vivek5391/6dof-robotic-arm-ros2/cad/sg servo.step

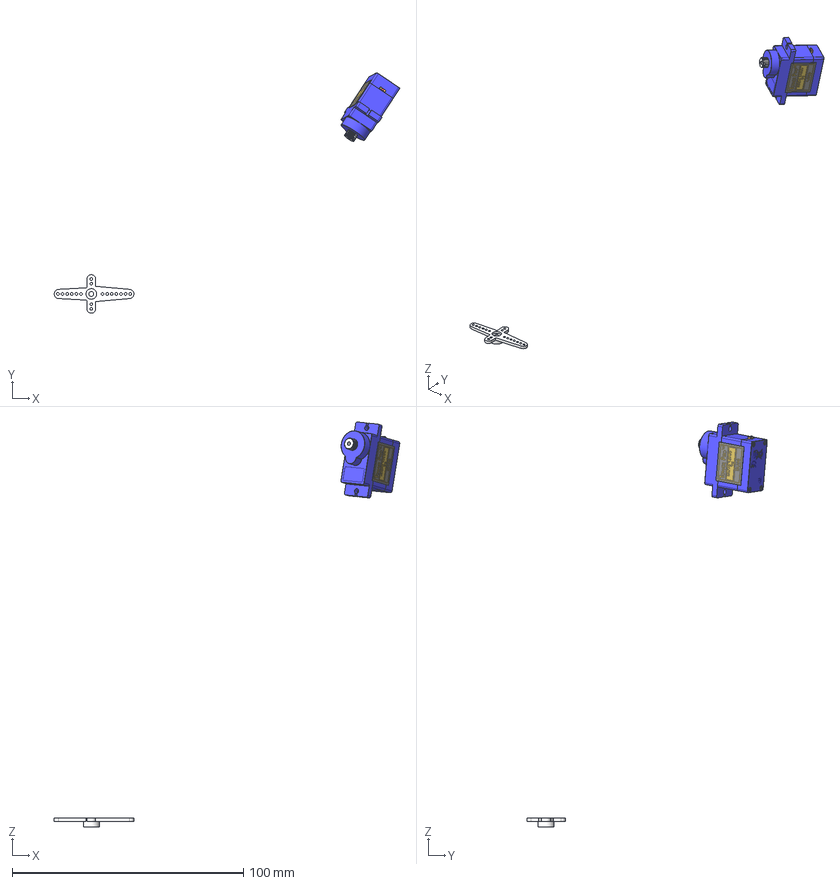
[picture p1: CAD file, 2026-10-06]
cad/sg servo.step
149.6 x 104.1 x 175.3 mm
SG90 - Micro Servo 9g - Tower Pro.1_Pea
SG90 - Micro Servo 9g - Tower Pro.4_Pea
