vivek5391/6dof-robotic-arm-ros2/meshes/gripper_right_finger.stl

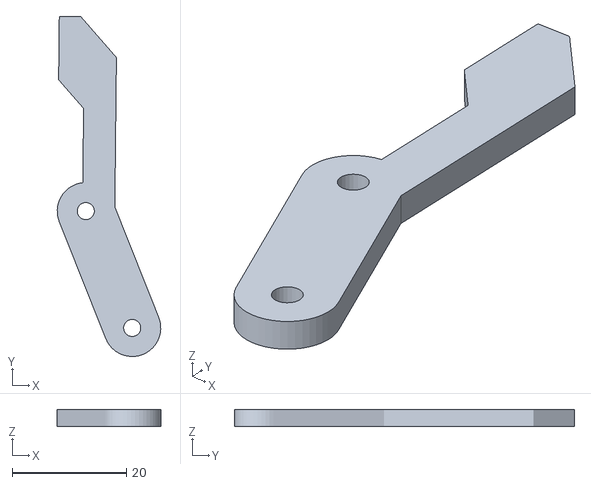
[picture p2: CAD file, 2026-10-06]
meshes/gripper_right_finger.stl
18.1 x 59.5 x 3.00
