vivek5391/6dof-robotic-arm-ros2/cad/body1.step

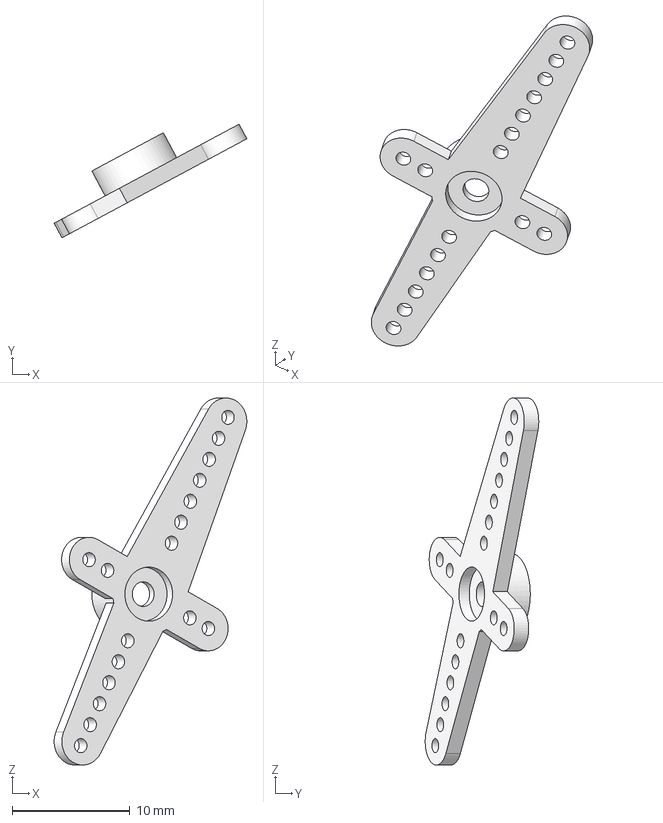
[picture p3: CAD file, 2026-10-06]
cad/body1.step
16.4 x 9.65 x 31.2 mm
