vivek5391/6dof-robotic-arm-ros2/meshes/gripper_left_gear.stl

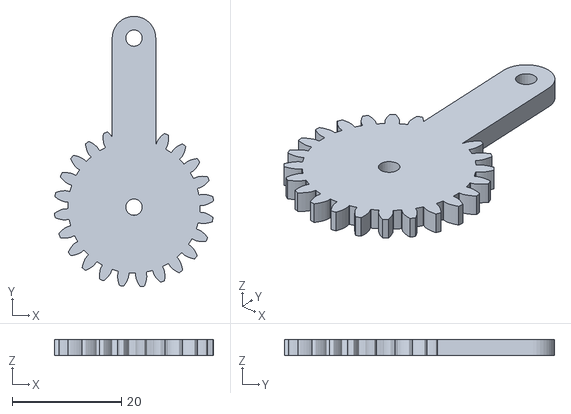
[picture p4: CAD file, 2026-10-06]
meshes/gripper_left_gear.stl
29.2 x 49.6 x 3.00
