vivek5391/6dof-robotic-arm-ros2/cad/DOF Robotic arm v2.step

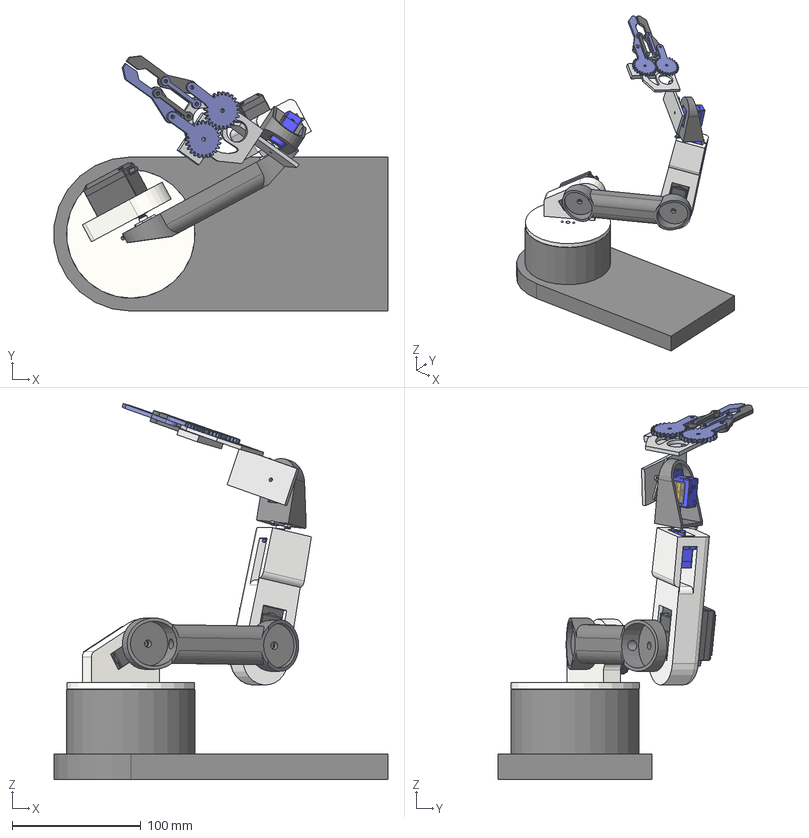
[picture p5: CAD file, 2026-10-06]
cad/DOF Robotic arm v2.step
259.6 x 198.6 x 292.6 mm
Shoulder
Elbow
arm
Base
Wrist
Spur Gear (24 teeth) (1)
Component2(Mirror)
Component1(Mirror)
SG90 - Micro Servo 9g - Tower Pro.1_Pea x 2
SG90 - Micro Servo 9g - Tower Pro.4_Pea x 2
SG90 - Micro Servo 9g - Tower Pro.4_Pea_1 x 3
