vivek5391/6dof-robotic-arm-ros2/meshes/Gripper v4.stl

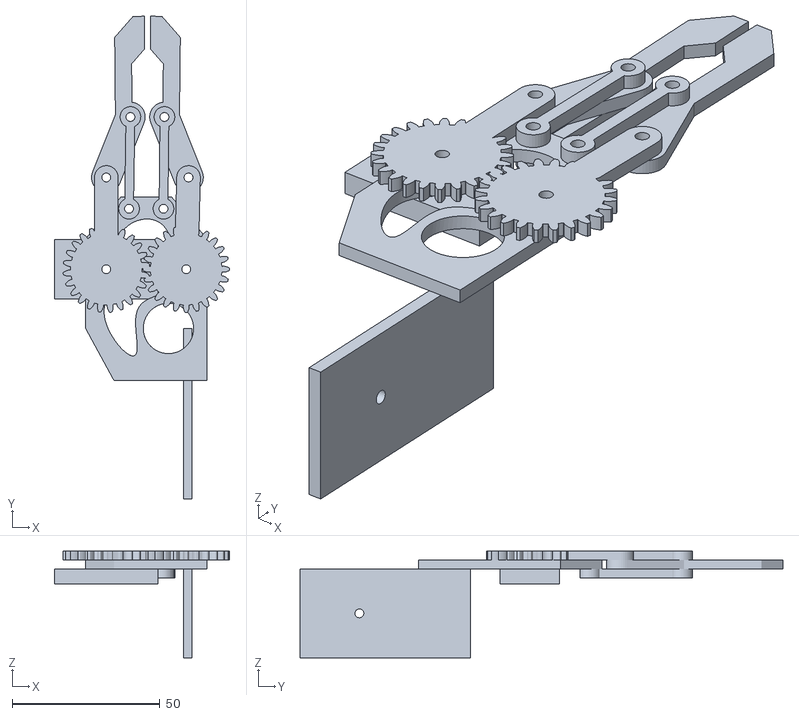
[picture p6: CAD file, 2026-10-06]
meshes/Gripper v4.stl
59.1 x 163.0 x 36.0
