vivek5391/6dof-robotic-arm-ros2/cad/MG995 v2 (1).step

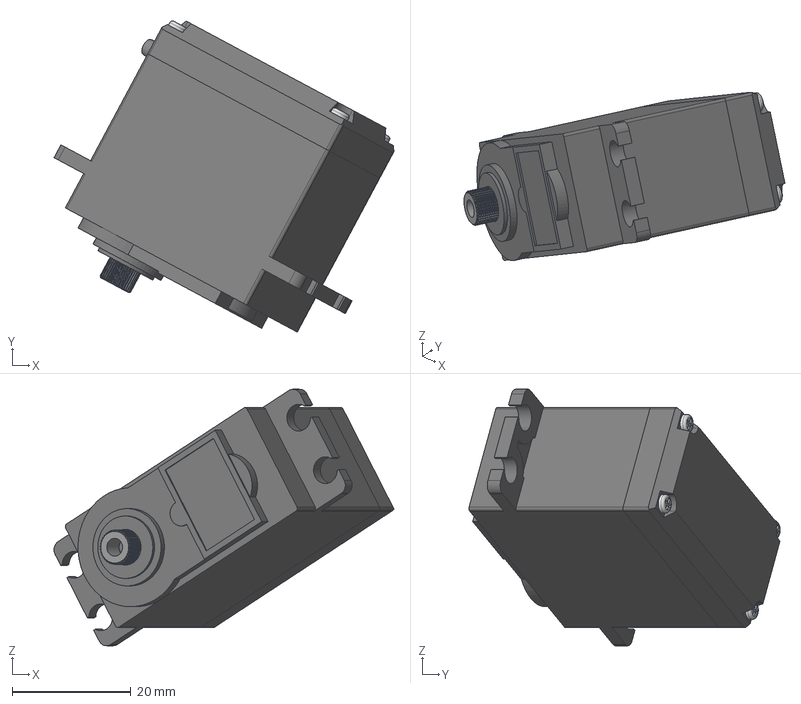
[picture p7: CAD file, 2026-10-06]
cad/MG995 v2 (1).step
57.2 x 52.4 x 43.1 mm
