vivek5391/6dof-robotic-arm-ros2/meshes/Shoulder.stl

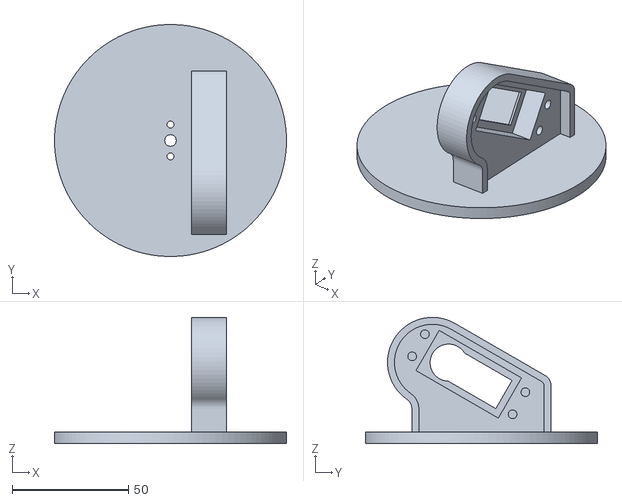
[picture p8: CAD file, 2026-10-06]
meshes/Shoulder.stl
100.0 x 100.0 x 54.4
