vivek5391/6dof-robotic-arm-ros2/meshes/Base.stl

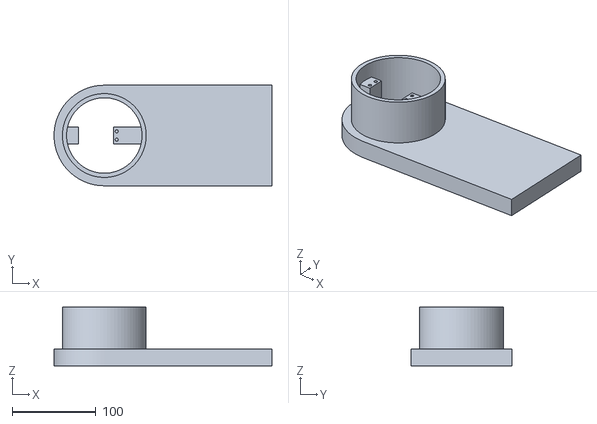
[picture p9: CAD file, 2026-10-06]
meshes/Base.stl
260.0 x 120.0 x 70.0
