vivek5391/6dof-robotic-arm-ros2/meshes/Wrist_.stl

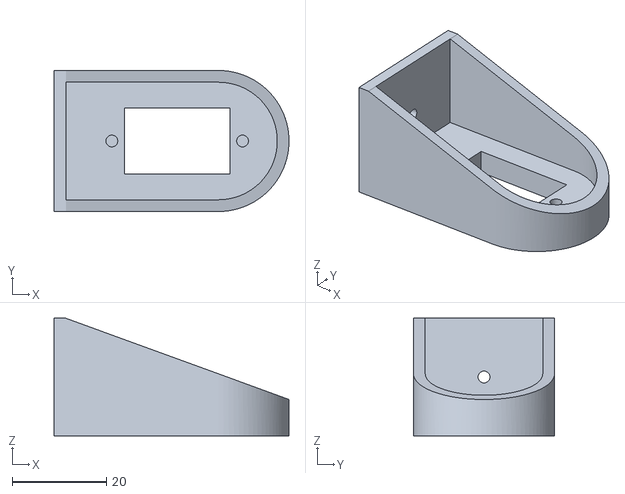
[picture p10: CAD file, 2026-10-06]
meshes/Wrist_.stl
50.0 x 30.0 x 25.0
