vivek5391/6dof-robotic-arm-ros2/meshes/arm.stl

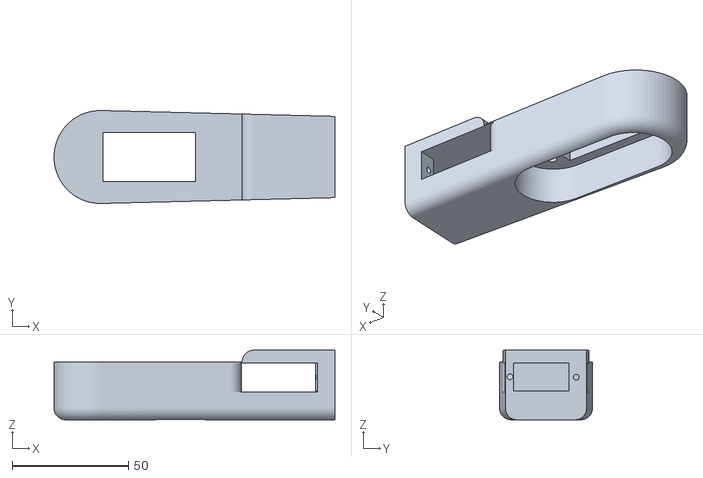
[picture p11: CAD file, 2026-10-06]
meshes/arm.stl
121.0 x 40.0 x 30.0
