vivek5391/6dof-robotic-arm-ros2/meshes/gripper_right_inner.stl

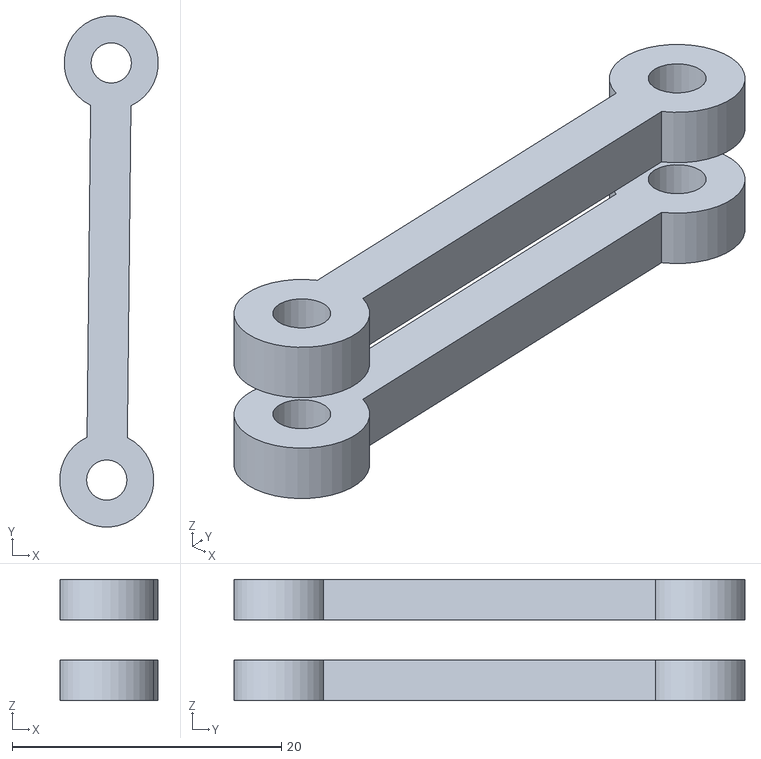
[picture p12: CAD file, 2026-10-06]
meshes/gripper_right_inner.stl
7.31 x 38.0 x 9.00
