vivek5391/6dof-robotic-arm-ros2/meshes/Elbow.stl

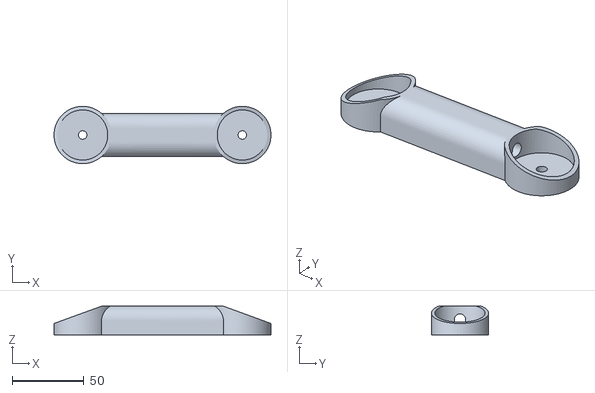
[picture p13: CAD file, 2026-10-06]
meshes/Elbow.stl
151.5 x 40.0 x 20.0
