vivek5391/6dof-robotic-arm-ros2/meshes/sg servo.stl

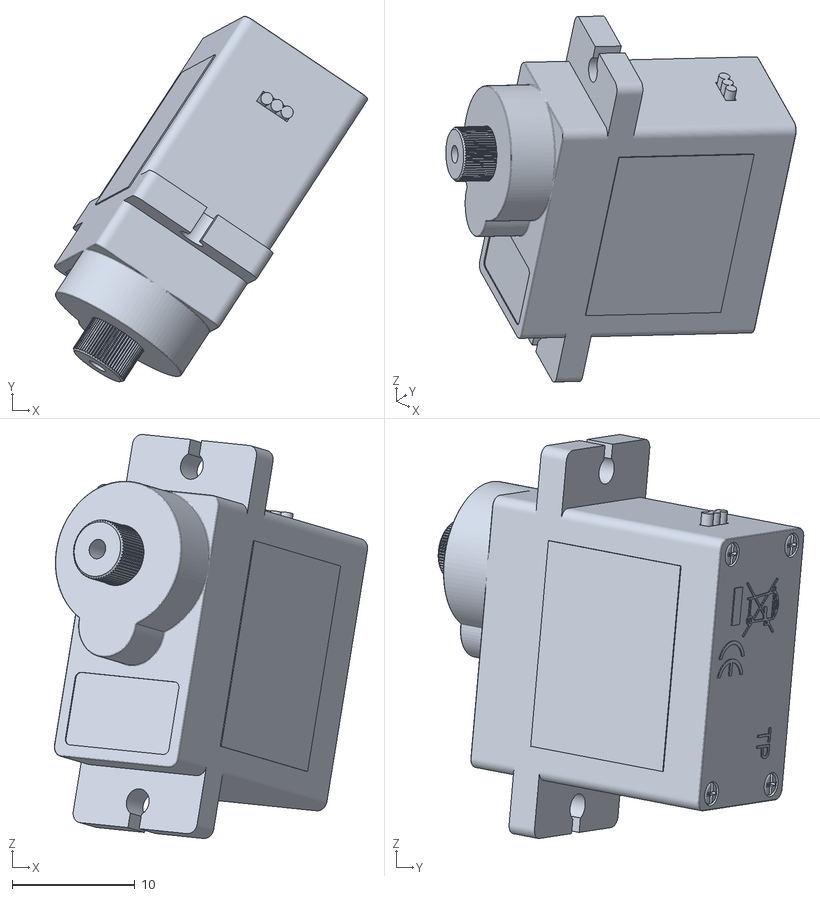
[picture p14: CAD file, 2026-10-06]
meshes/sg servo.stl
25.5 x 29.7 x 32.9
