vivek5391/6dof-robotic-arm-ros2/meshes/gripper_left_inner.stl

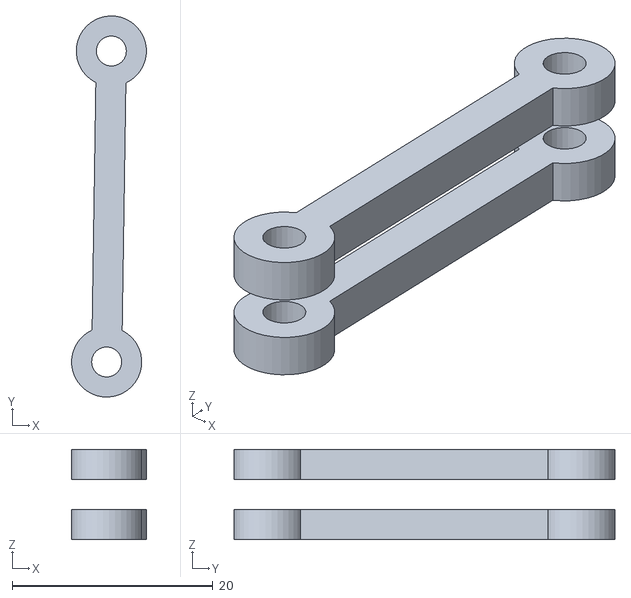
[picture p15: CAD file, 2026-10-06]
meshes/gripper_left_inner.stl
7.45 x 38.0 x 9.00
