vivek5391/6dof-robotic-arm-ros2/meshes/gripper_base.stl

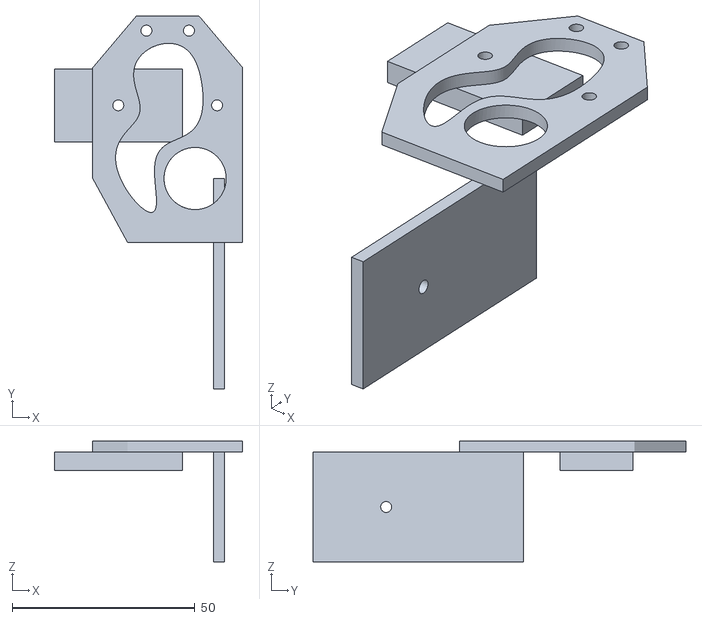
[picture p16: CAD file, 2026-10-06]
meshes/gripper_base.stl
51.5 x 102.0 x 33.0
