vivek5391/6dof-robotic-arm-ros2/(list of files, cad)

Other CAD files:
meshes/servo.stl
meshes/gripper_right_gear.stl
meshes/gripper_left_finger.stl
cad/Base.f3d
cad/Elbow.f3d
cad/Gripper v4.f3d
cad/Shoulder .f3d
cad/Wrist .f3d
cad/arm.f3d
cad/servo boday.f3d
