vivek5391/6dof-robotic-arm-ros2/cad/DOF Robotic arm v2 Drawing.pdf

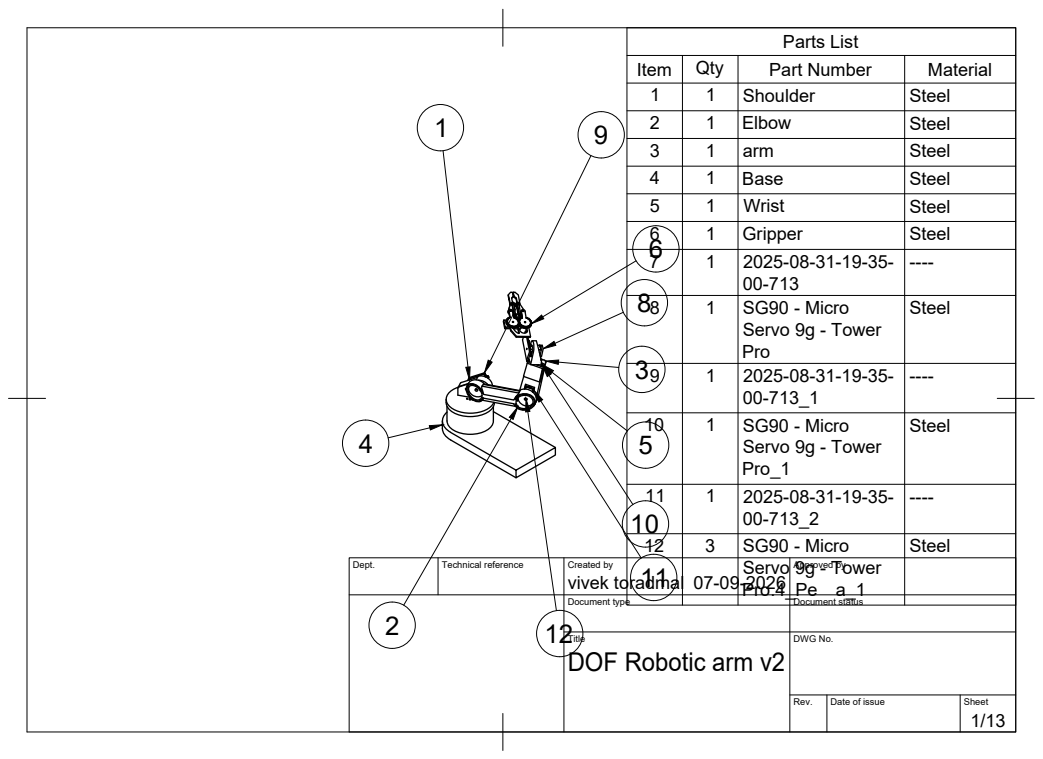
[picture p17: page 1]
Document type; Document status; Parts List

Item | Qty | Part Number | Material
1 | 1 | Shoulder | Steel
2 | 1 | Elbow | Steel
3 | 1 | arm | Steel
4 | 1 | Base | Steel
5 | 1 | Wrist | Steel
6 6 | 1 | Gripper | Steel
7 | 1 1 | SG90 - Micro 2025-08-31-19-35-00-713 | ---- 8

8 | | Servo 9g - Tower Pro | Steel

3 9 | 1 1 | SG90 - Micro 2025-08-31-19-35-00-713_1 | ---- 10

5 | | Servo 9g - Tower Pro_1 | Steel

11 10 | 3 1 | SG90 - Micro 2025-08-31-19-35-00-713_2 | ---- 12

Steel

Dept. | Technical reference | Created by vivek toradmal | 11 | 07-09-2026 | Servo 9g - Tower Pro.4_Pe a_1 | Approved by

Title DOF Robotic arm v2 | DWG No.

Rev. | Date of issue | Sheet

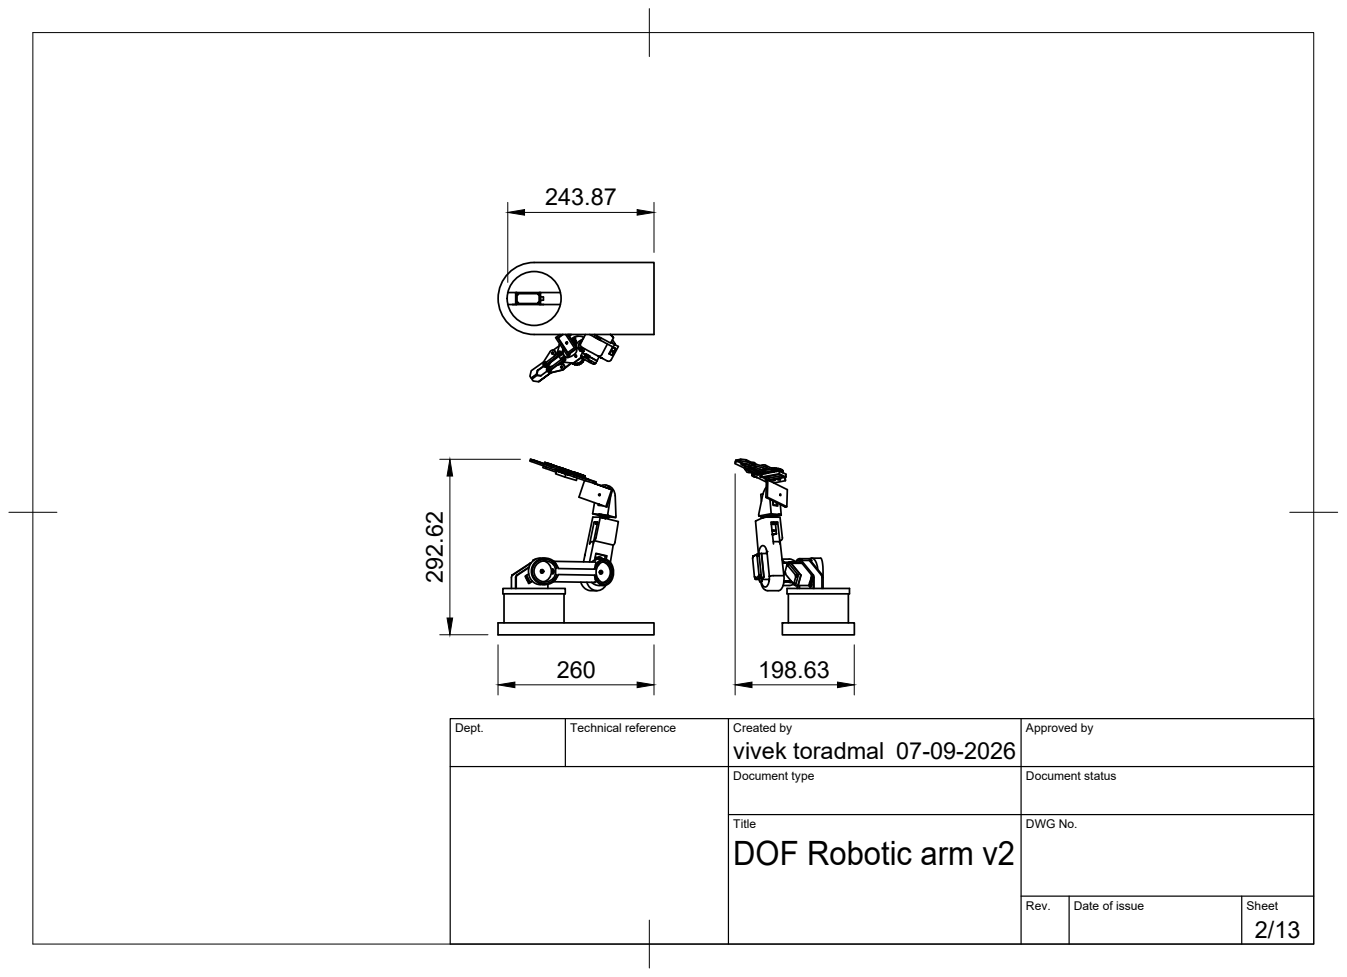
[picture p18: page 2]

Dept. | Technical reference | Created by vivek toradmal 07-09-2026 | Approved by

Document type | Document status

Title DOF Robotic arm v2 | DWG No.

Rev. | Date of issue | Sheet

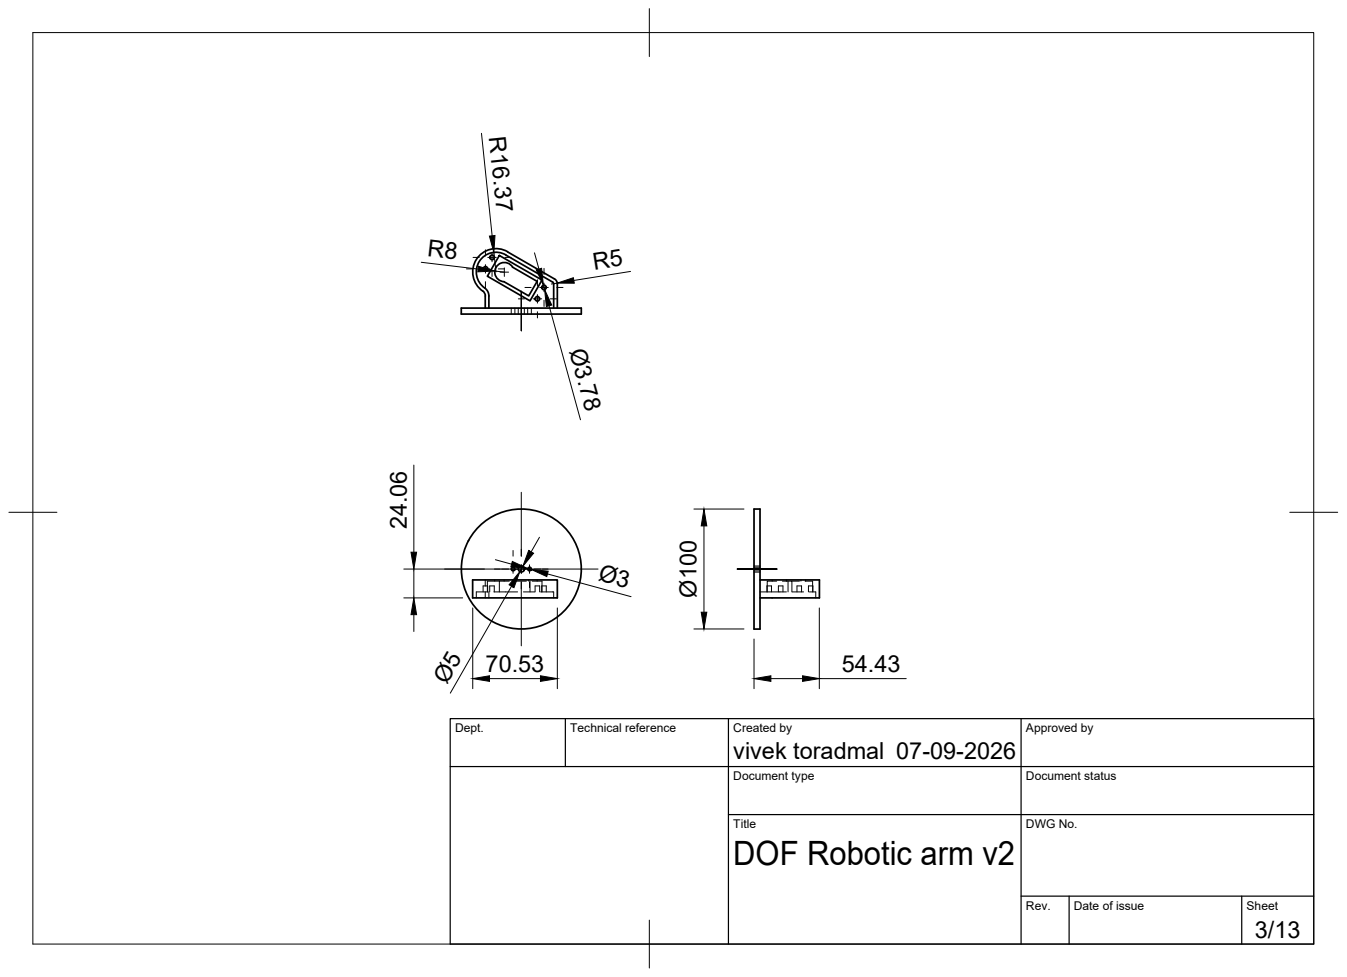
[picture p19: page 3]

Dept. | Technical reference | Created by vivek toradmal 07-09-2026 | Approved by

Document type | Document status

Title DOF Robotic arm v2 | DWG No.

Rev. | Date of issue | Sheet

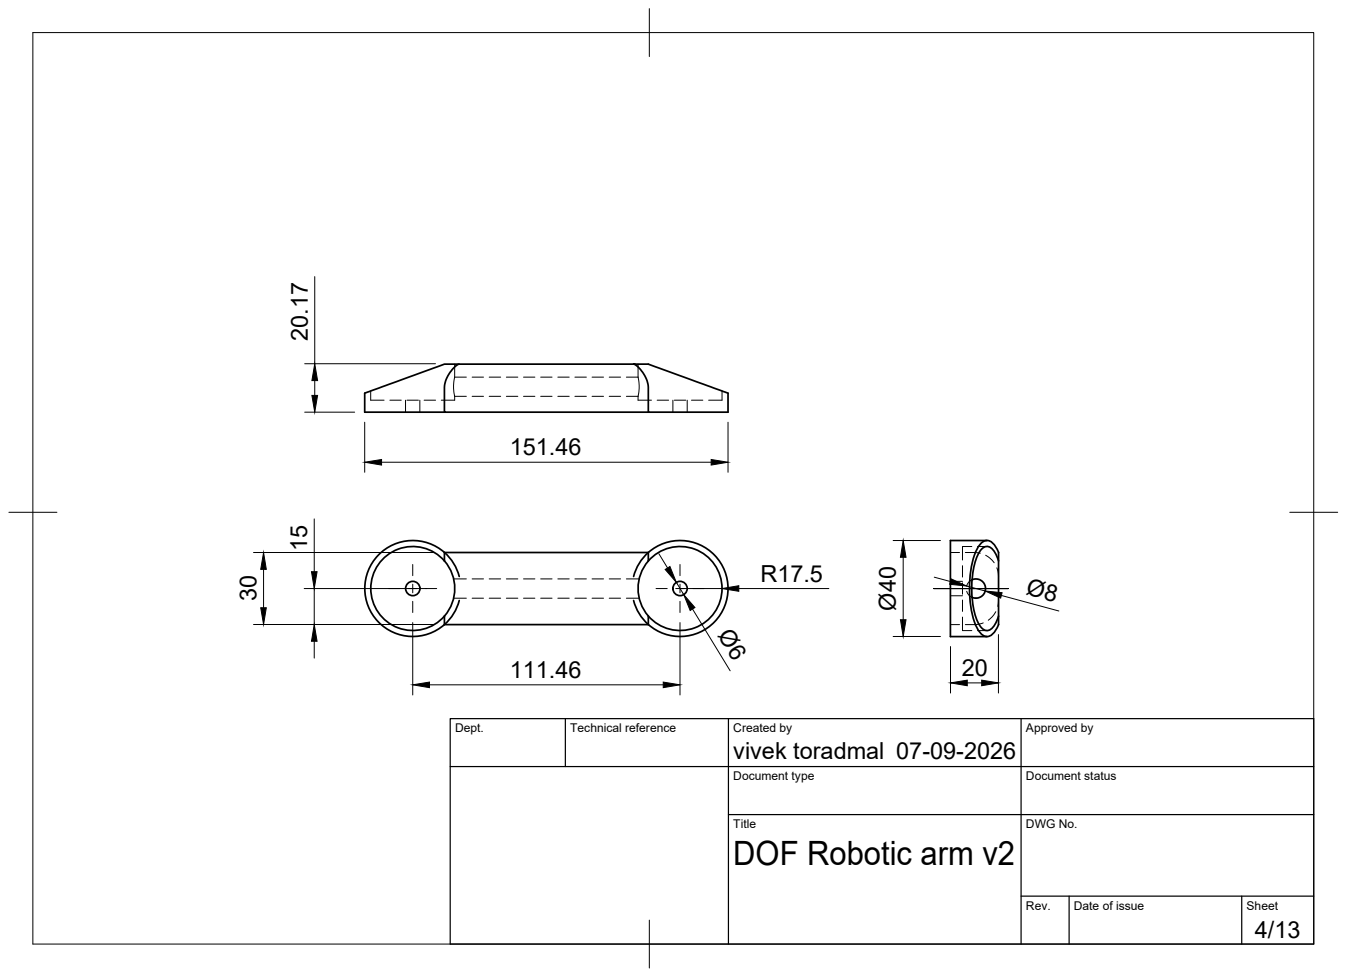
[picture p20: page 4]

Dept. | Technical reference | Created by vivek toradmal 07-09-2026 | Approved by

Document type | Document status

Title DOF Robotic arm v2 | DWG No.

Rev. | Date of issue | Sheet

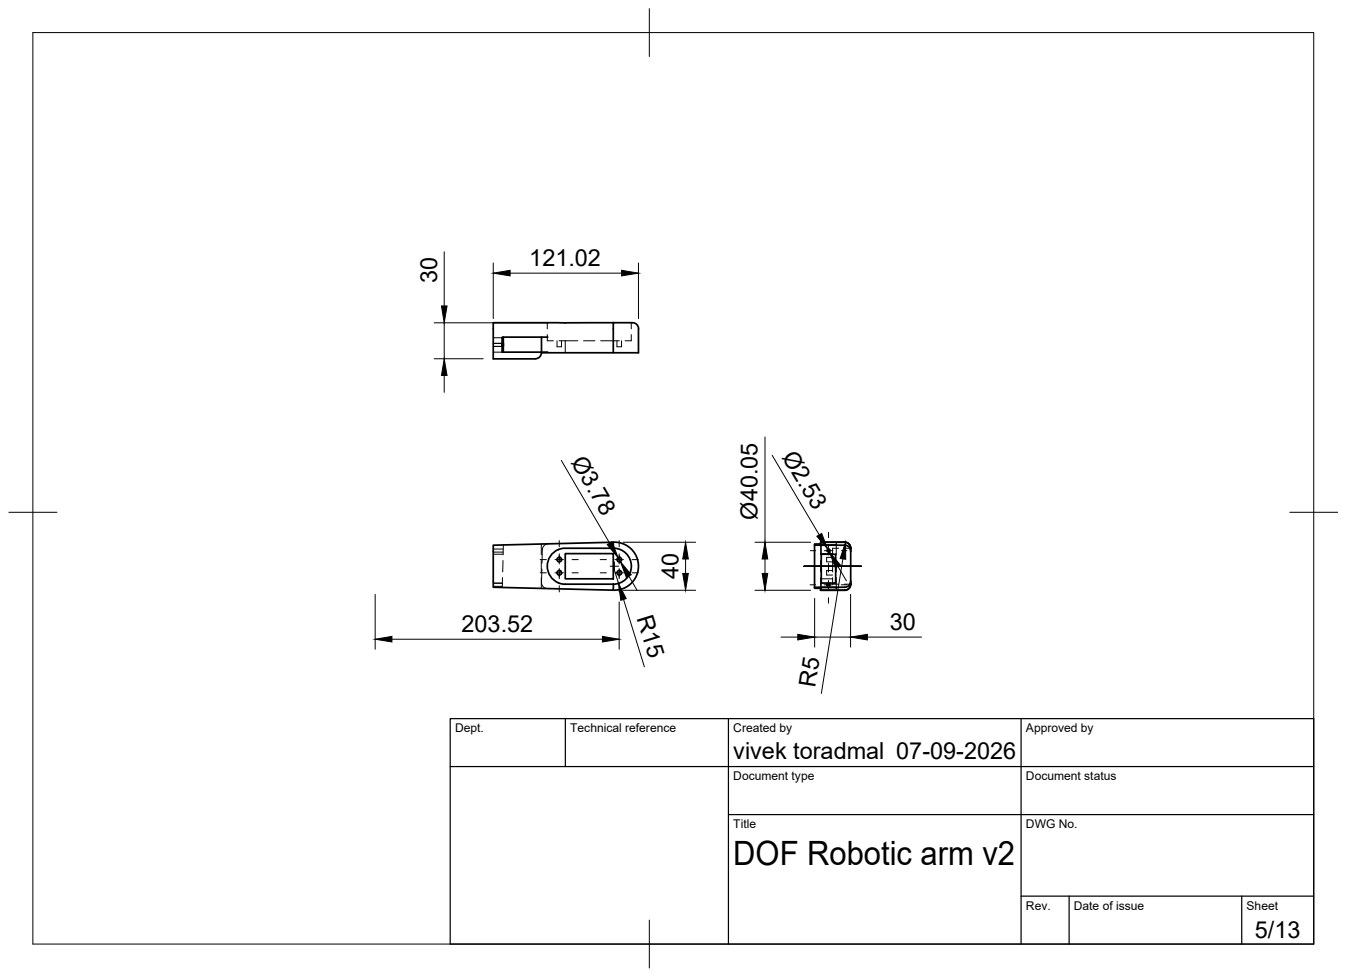
[picture p21: page 5]

Dept. | Technical reference | Created by vivek toradmal 07-09-2026 | Approved by

Document type | Document status

Title DOF Robotic arm v2 | DWG No.

Rev. | Date of issue | Sheet

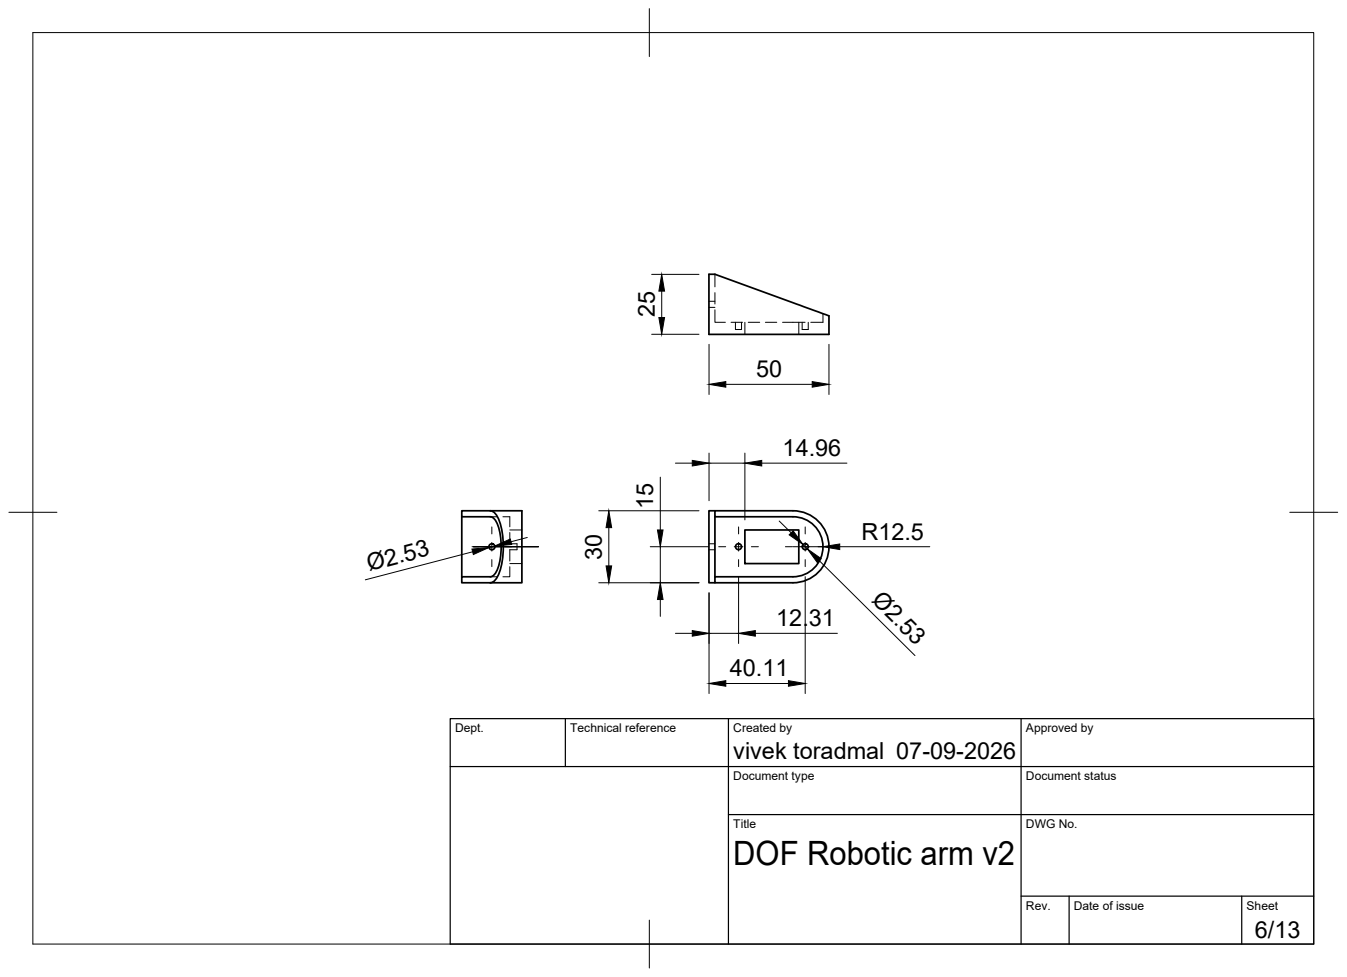
[picture p22: page 6]

Dept. | Technical reference | Created by vivek toradmal 07-09-2026 | Approved by

Document type | Document status

Title DOF Robotic arm v2 | DWG No.

Rev. | Date of issue | Sheet

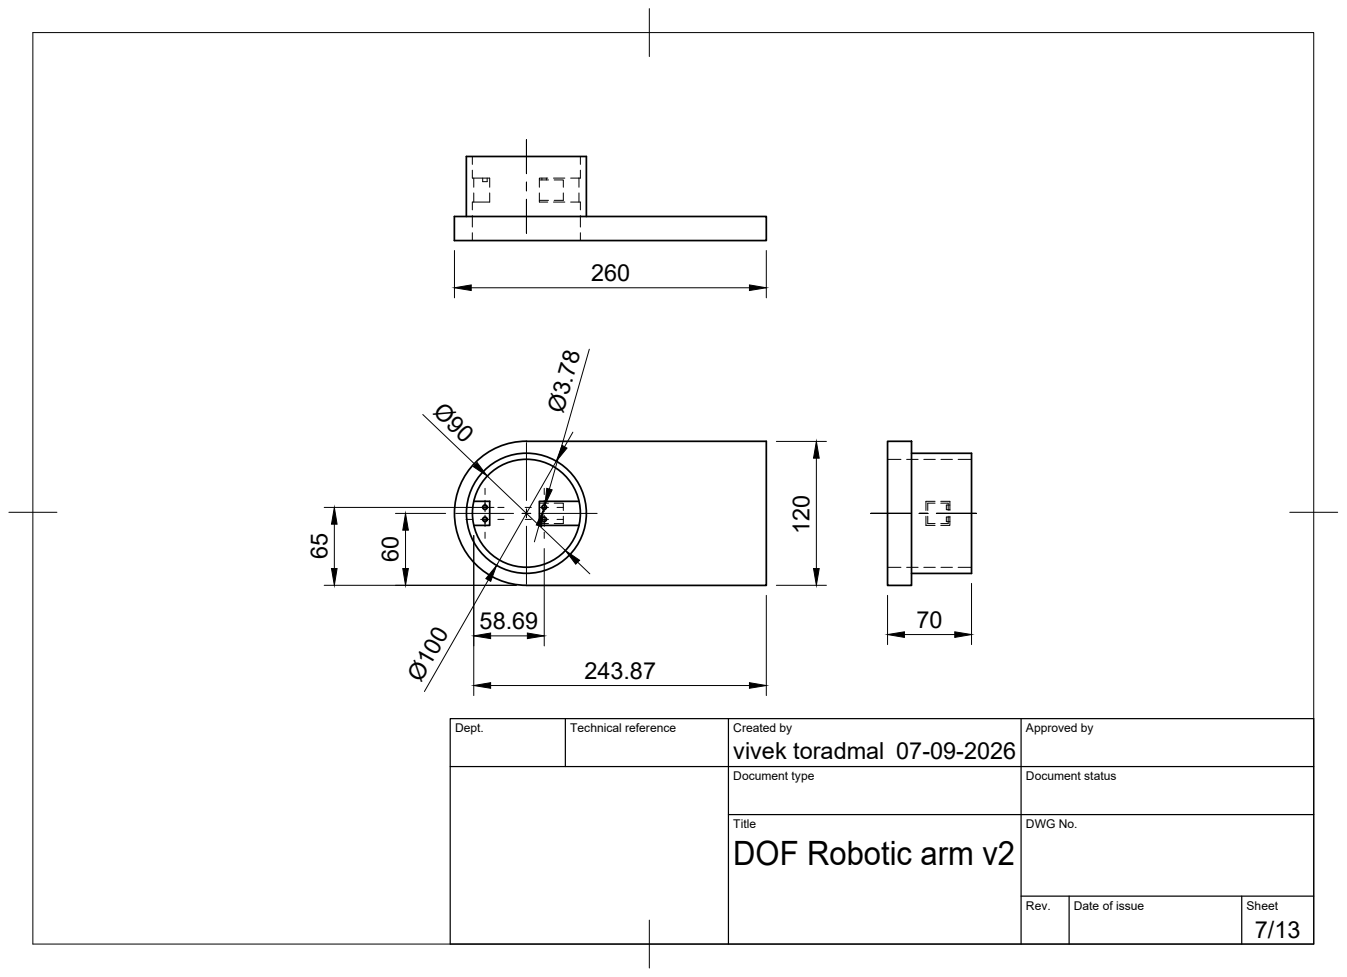
[picture p23: page 7]
vivek toradmal 120

Dept. | Technical reference | Created by 07-09-2026 | Approved by

Document type | Document status

Title DOF Robotic arm v2 | DWG No.

Rev. | Date of issue | Sheet

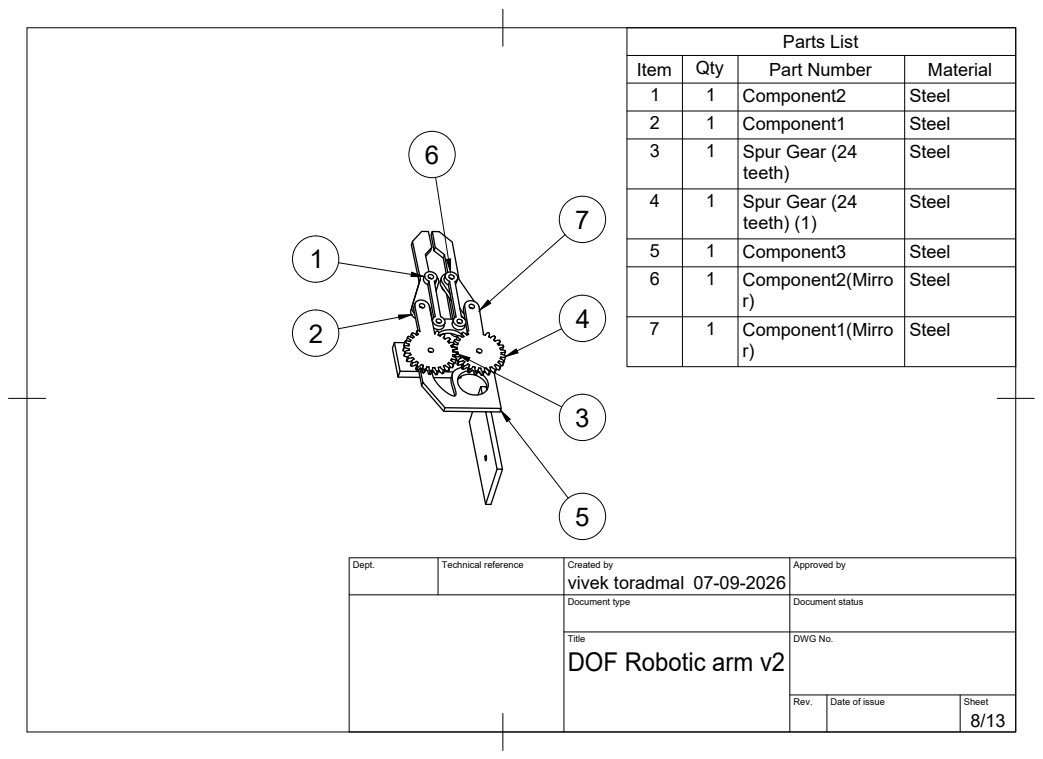
[picture p24: page 8]
Parts List

Item | Qty | Part Number | Material
1 | 1 | Component2 | Steel
2 | 1 | Component1 | Steel
3 | 1 | Spur Gear (24 teeth) | Steel

4 | 1 | Spur Gear (24 teeth) (1) | Steel

5 | 1 | Component3 | Steel
6 | 1 | Component2(Mirro r) | Steel

7 | 1 | Component1(Mirro r)

Dept. | Technical reference | Created by vivek toradmal 07-09-2026 | Approved by

Document type | Document status

Title DOF Robotic arm v2 | DWG No.

Rev. | Date of issue | Sheet

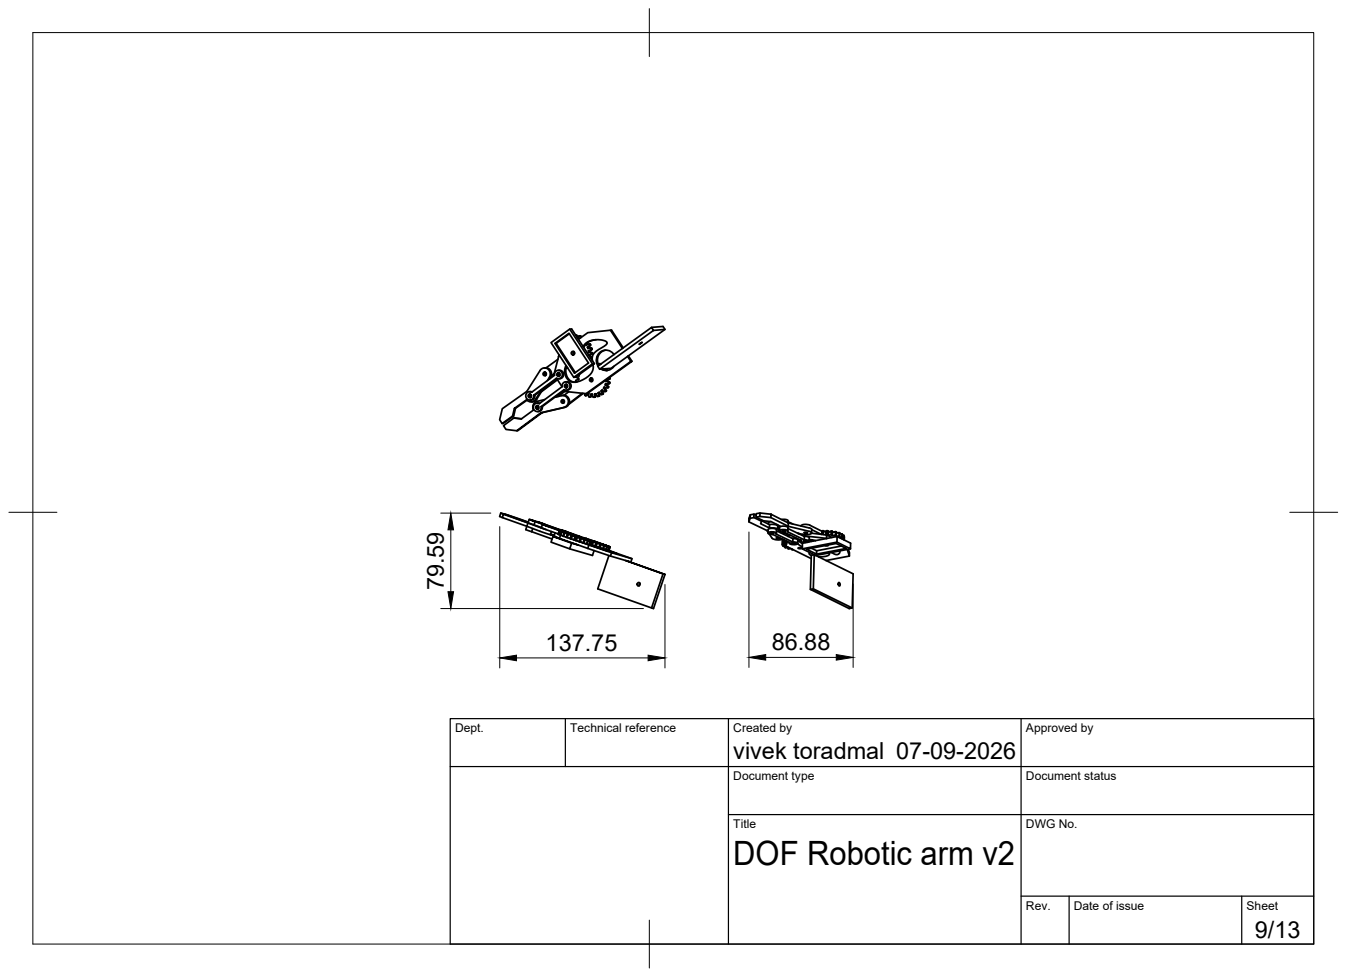
[picture p25: page 9]

Dept. | Technical reference | Created by vivek toradmal 07-09-2026 | Approved by

Document type | Document status

Title DOF Robotic arm v2 | DWG No.

Rev. | Date of issue | Sheet

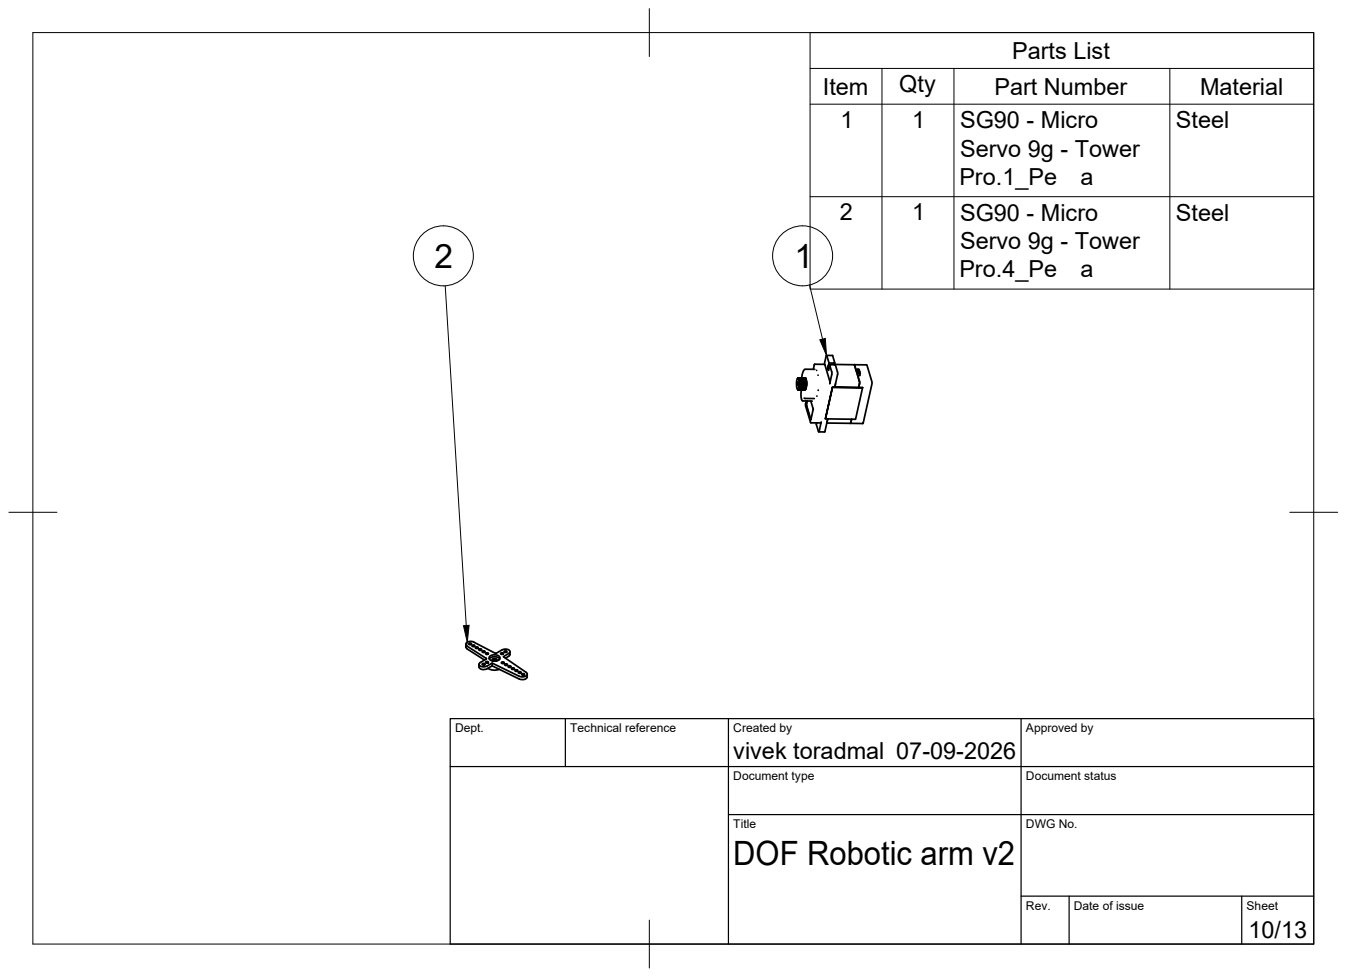
[picture p26: page 10]
Parts List

Item | Qty | Part Number | Material
1 | 1 | SG90 - Micro Servo 9g - Tower Pro.1_Pe a | Steel

2 | 1 | SG90 - Micro Servo 9g - Tower Pro.4_Pe a | Steel

Dept. | Technical reference | Created by vivek toradmal 07-09-2026 | Approved by

Document type | Document status

Title DOF Robotic arm v2 | DWG No.

Rev. | Date of issue | Sheet

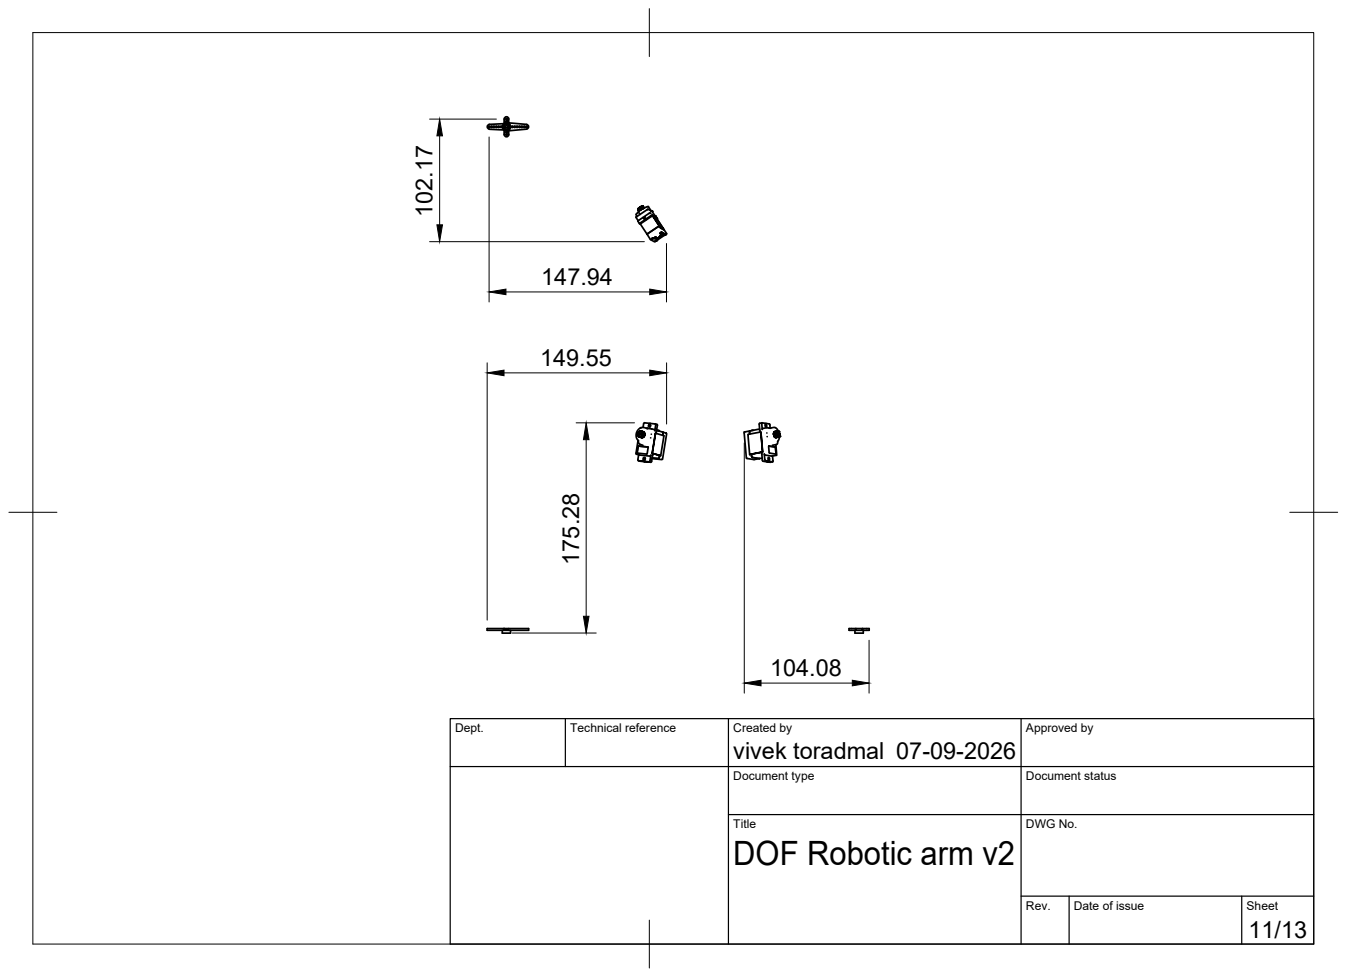
[picture p27: page 11]
vivek toradmal 175.28

Dept. | Technical reference | Created by 07-09-2026 | Approved by

Document type | Document status

Title DOF Robotic arm v2 | DWG No.

Rev. | Date of issue | Sheet

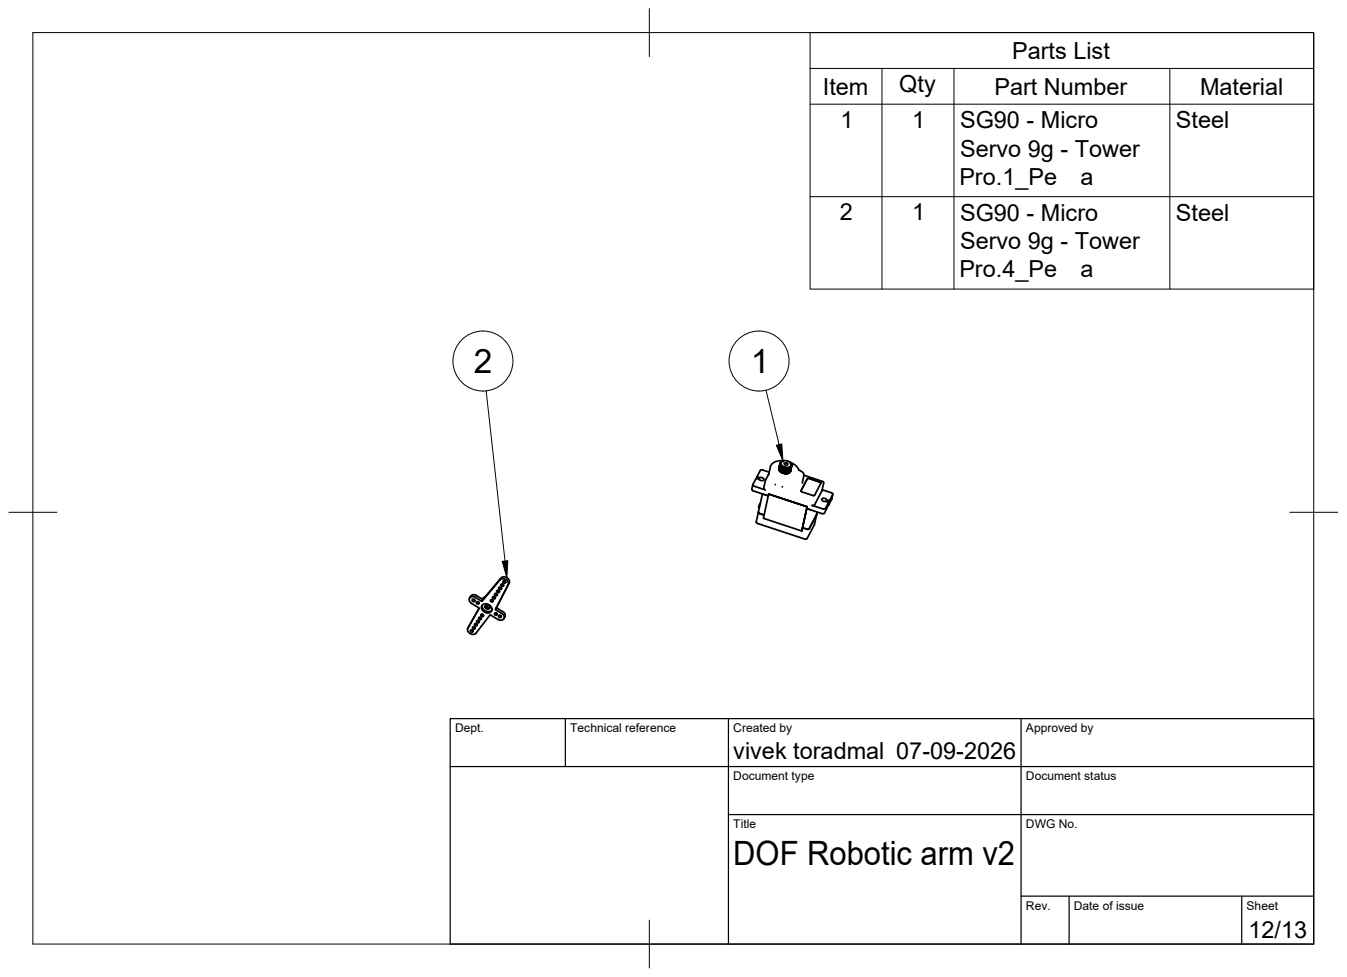
[picture p28: page 12]
Parts List

Item | Qty | Part Number | Material
1 | 1 | SG90 - Micro Servo 9g - Tower Pro.1_Pe a | Steel

2 | 1 | SG90 - Micro Servo 9g - Tower Pro.4_Pe a | Steel

Dept. | Technical reference | Created by vivek toradmal 07-09-2026 | Approved by

Document type | Document status

Title DOF Robotic arm v2 | DWG No.

Rev. | Date of issue | Sheet

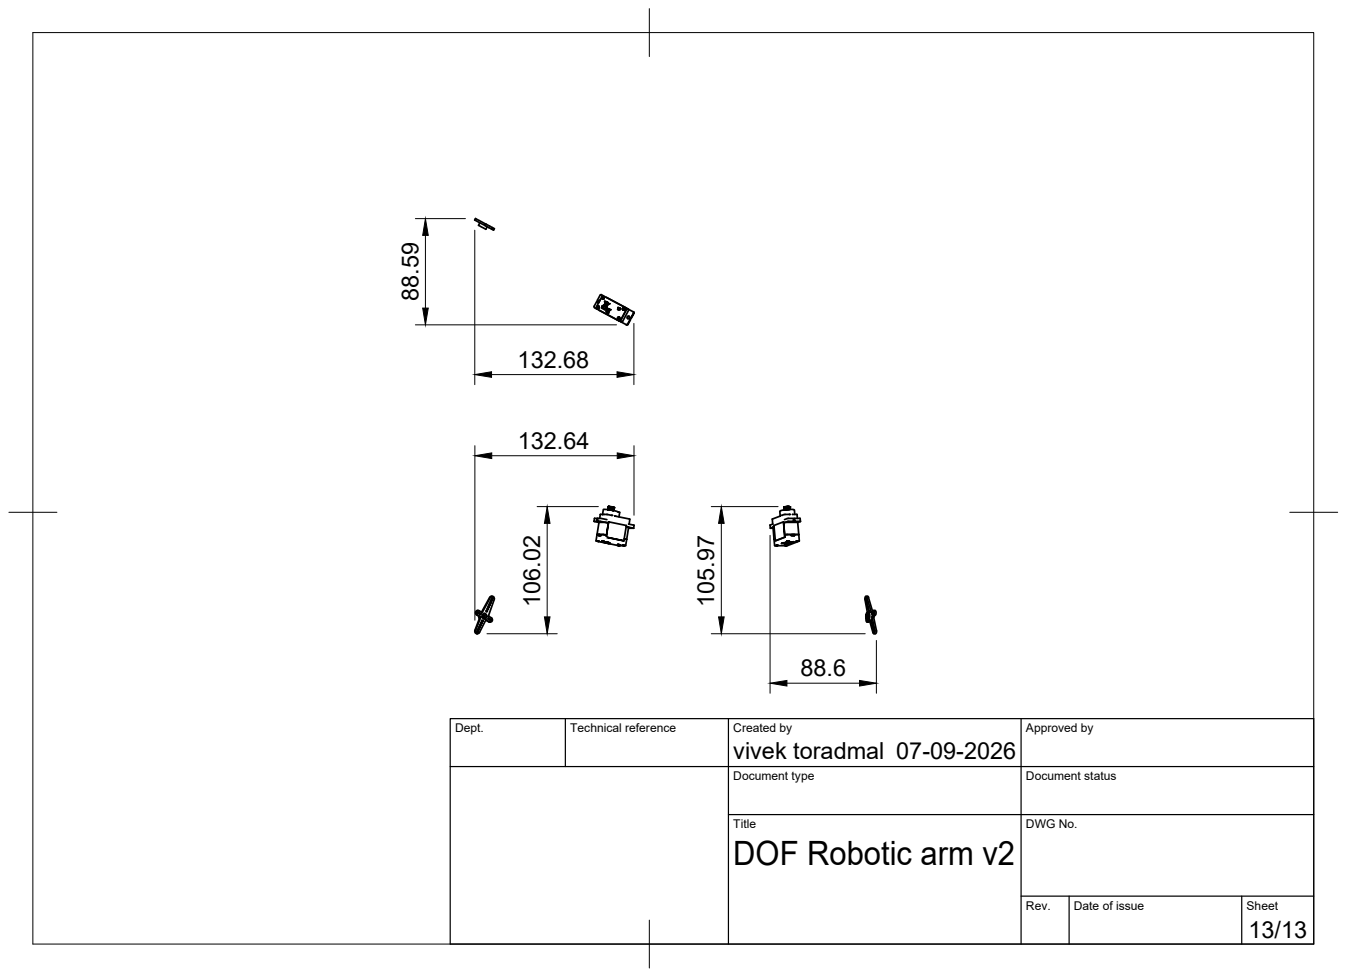
[picture p29: page 13]

Dept. | Technical reference | Created by vivek toradmal 07-09-2026 | Approved by

Document type | Document status

Title DOF Robotic arm v2 | DWG No.

Rev. | Date of issue | Sheet
