vivek5391/6dof-robotic-arm-ros2/cad/Base design Drawing.pdf

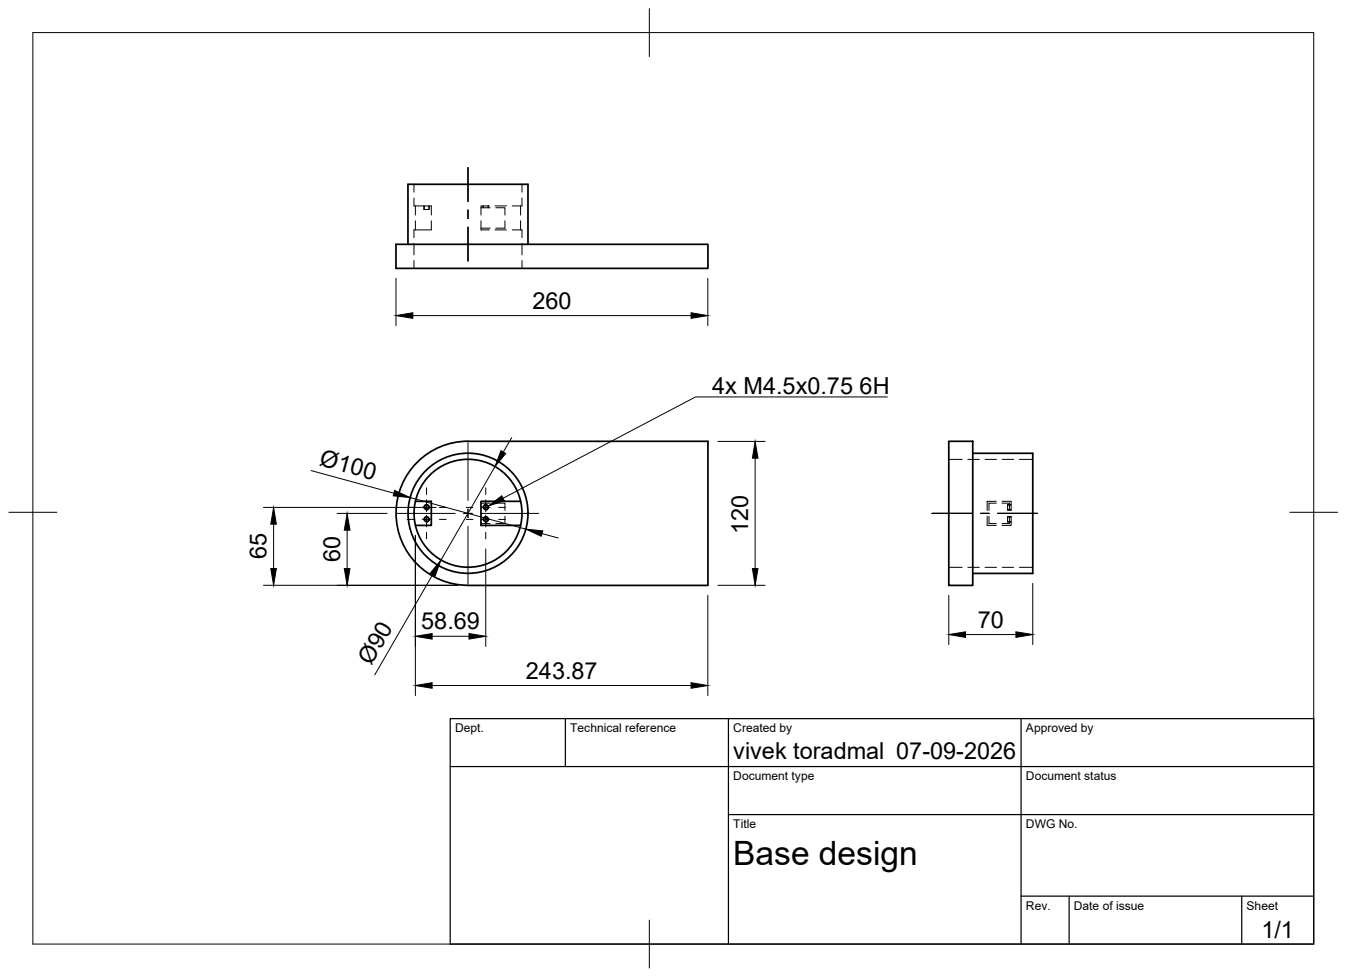
[picture p30: page 1]
vivek toradmal 120

Dept. | Technical reference | Created by 07-09-2026 | Approved by

Document type | Document status

Title Base design | DWG No.

Rev. | Date of issue | Sheet 1/1
