vivek5391/6dof-robotic-arm-ros2/(commit log)

2026-10-06 Initial commit: 5-DOF Articulated Robotic Arm ROS 2 Humble Digital Twin, URDF, CAD, and Web Command Studio
2026-10-17 Clarify robotic arm validation status and avoid unverified specifications
2026-10-17 Mark robotic arm specs as unverified and fix repository-relative links
2026-10-17 Remove unsupported robotic arm performance claims
